4TuNAs/hp-printer-lcd-reverse-engineering-AUO-59.02A42.005-ESP32/docs/img/sky-modes.jpg

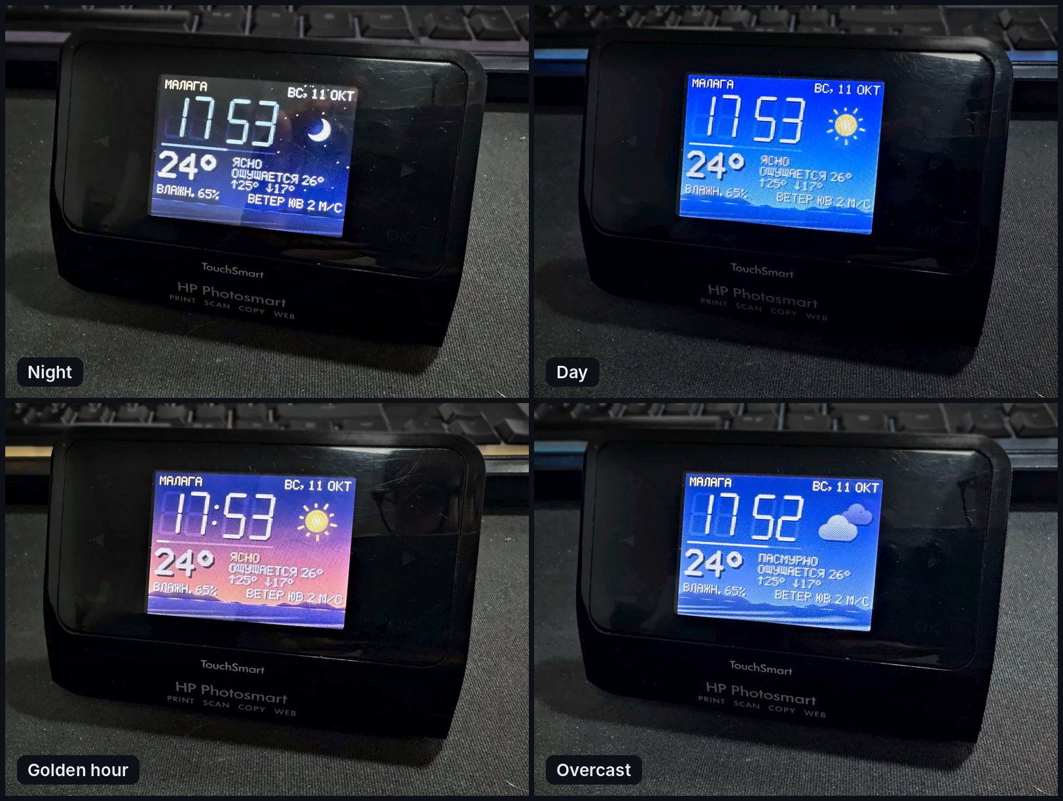
docs/img/sky-modes.jpg
