4TuNAs/hp-printer-lcd-reverse-engineering-AUO-59.02A42.005-ESP32/case/case-body.stl

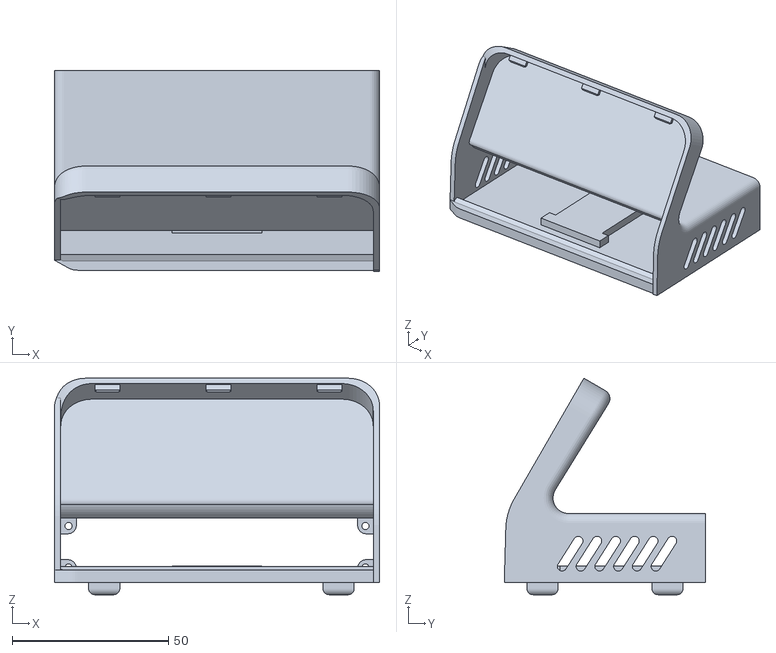
[picture p9: CAD file, 2026-10-11]
case/case-body.stl
104.0 x 64.5 x 69.3
