4TuNAs/hp-printer-lcd-reverse-engineering-AUO-59.02A42.005-ESP32/(commit log)

2026-10-09 Add board reverse-engineering notes
2026-10-09 Update LCD timing diagram for current 10 MHz DMA implementation
2026-10-09 Add ESP32 LCD pipeline block diagram
2026-10-09 Replace legacy 10 MHz firmware with current UPS052 16 MHz RGB565 DMA build; externalize Wi-Fi credentials
    [AUO_Weather.ino]
2026-10-09 Document disconnecting the Cypress from the LCD serial lines
    The CY8C20546 occasionally switched the panel to UPS051 mode at power-on
    (stretched, shifted, scrambled image until the next power cycle). Its SDA
    and SCL pins were lifted so it can no longer reconfigure the LCD; the panel
    now stays in its default UPS052 320RGB mode.
    Claude-Session: https://claude.ai/code/session_017vPoEXupCYA69CXXPfG1EP
2026-10-11 Add 3D-printed stand and sky-mode photos
    - case/: Bambu Studio project (Clock_V1.3mf) plus STL files for the body
    and the back cover
    - README: new "3D-printed stand" section with renders, a turntable GIF,
    a photo of the printed part, part sizes and print settings
    - README: photo collage of the four sky modes (night, day, golden hour,
    overcast) and an "Overcast" row in the sky-modes table
    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
